zebular13/BluetoothANDColorSensor/README.md

BluetoothANDColorSensor
=======================

Bluetooth and Color Sensor
