zebular13/BluetoothANDColorSensor/(commit log)

2014-08-06 added timer back to file. I'd forgotten I'd edited it out before my last commit
2014-08-08 adding a delay to the color sensor
2014-08-15 attempting to make long press turn button on and off within sketch. Still troubleshooting...
2014-08-19 This code sort of works to turn arduino off with a button and on with the serial
